Lycosaurus/Vcheck---custom_PCB_and_Arduino-Nano/SCH_Accel Sensing Unit_1-ASU Schematic_2024-08-31.pdf

# YOUT 10 NC 11 XOUT 12 NC 13 VS 14 VS 15 NC 16 EP 17

# ADXL335 Analog G Sensor

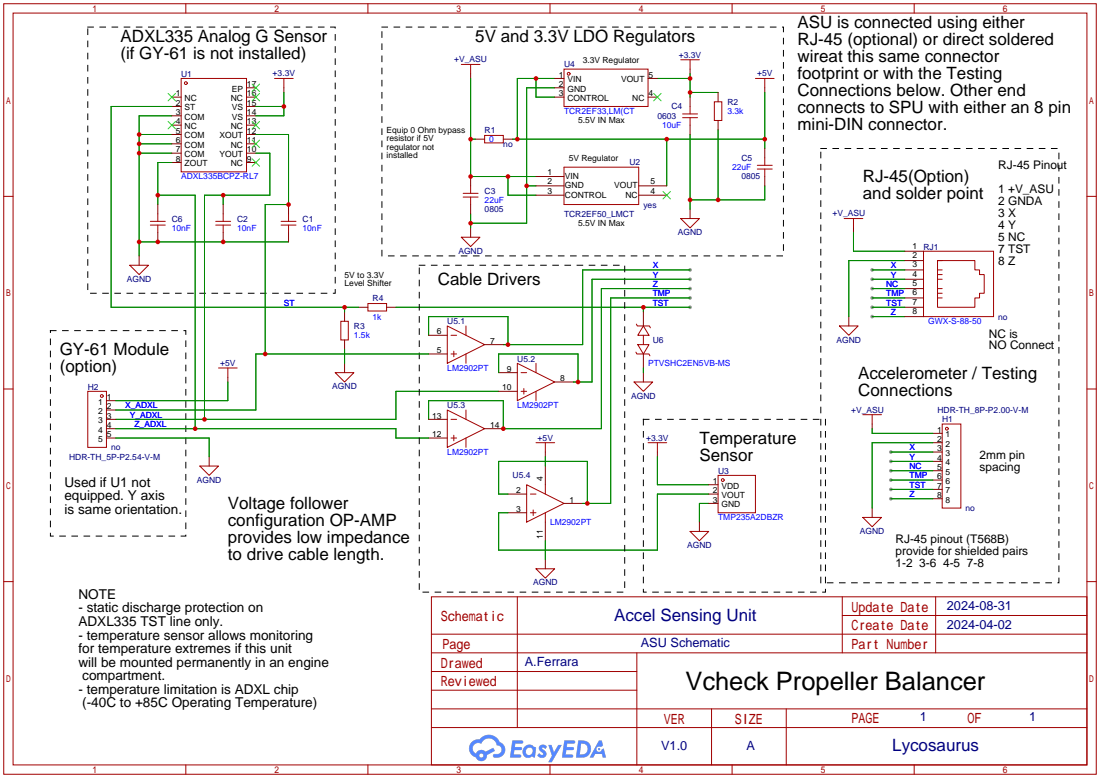
[picture p27: page 1]

ASU is connected using either
RJ-45 (optional) or direct soldered
wireat this same connector
footprint or with the Testing
Connections below. Other end
connects to SPU with either an 8 pin
mini-DIN connector.

(if GY-61 is not installed)

AGND
Voltage follower
configuration OP-AMP
provides low impedance
to drive cable length.

NOTE
- static discharge protection on
ADXL335 TST line only.
- temperature sensor allows monitoring
for temperature extremes if this unit
will be mounted permanently in an engine
compartment.
- temperature limitation is ADXL chip
(-40C to +85C Operating Temperature)
