Lycosaurus/Vcheck---custom_PCB_and_Arduino-Nano/SCH_Signal Processing Unit_1-Power Supply_2024-08-31.pdf

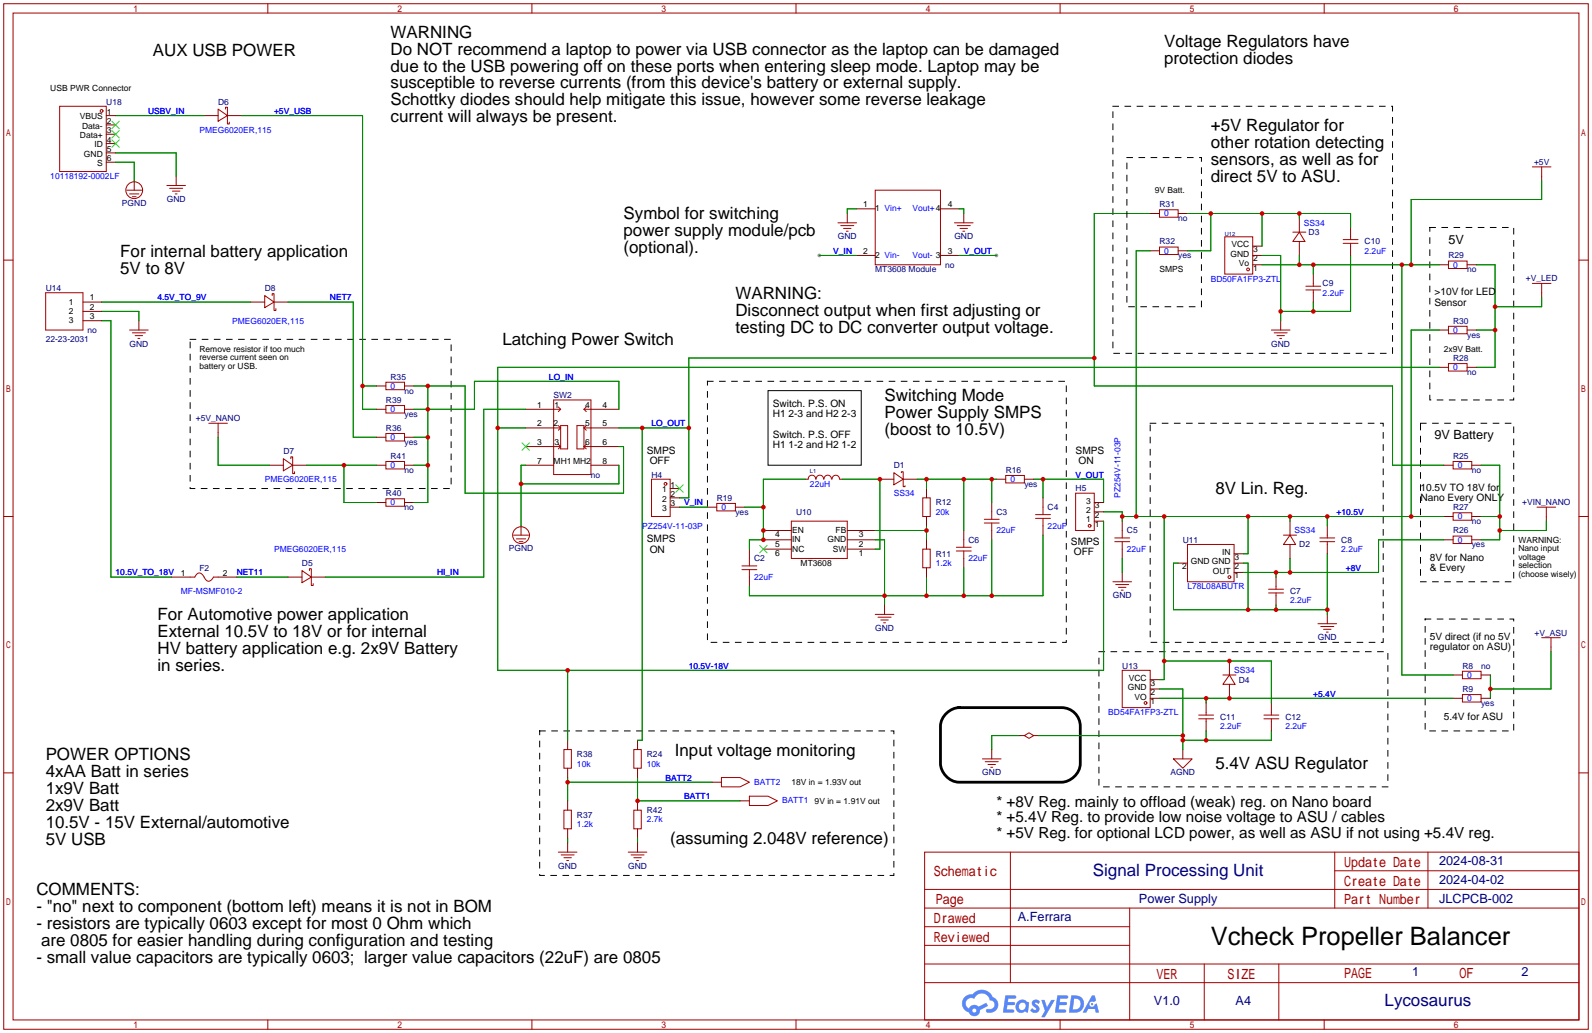
[picture p28: page 1]

WARNING
Do NOT recommend a laptop to power via USB connector as the laptop can be damaged
due to the USB powering off on these ports when entering sleep mode. Laptop may be
susceptible to reverse currents (from this device's battery or external supply.
Schottky diodes should help mitigate this issue, however some reverse leakage
current will always be present.

+5V Regulator for
other rotation detecting
sensors, as well as for
direct 5V to ASU.

PGND
For internal battery application

Symbol for switching
power supply module/pcb
(optional).

WARNING:
Disconnect output when first adjusting or
testing DC to DC converter output voltage.

Remove resistor if too much
reverse current seen on
battery or USB.

MF-MSMF010-2
For Automotive power application
External 10.5V to 18V or for internal
HV battery application e.g. 2x9V Battery
in series.

GND
* +8V Reg. mainly to offload (weak) reg. on Nano board
* +5.4V Reg. to provide low noise voltage to ASU / cables
* +5V Reg. for optional LCD power, as well as ASU if not using +5.4V reg.

COMMENTS:
- "no" next to component (bottom left) means it is not in BOM
- resistors are typically 0603 except for most 0 Ohm which
are 0805 for easier handling during configuration and testing
- small value capacitors are typically 0603; larger value capacitors (22uF) are 0805
