Lycosaurus/Vcheck---custom_PCB_and_Arduino-Nano/SCH_Signal Processing Unit_2-Processing and I-O_2024-08-31.pdf

# Acceleration Sensor and Axis Selector

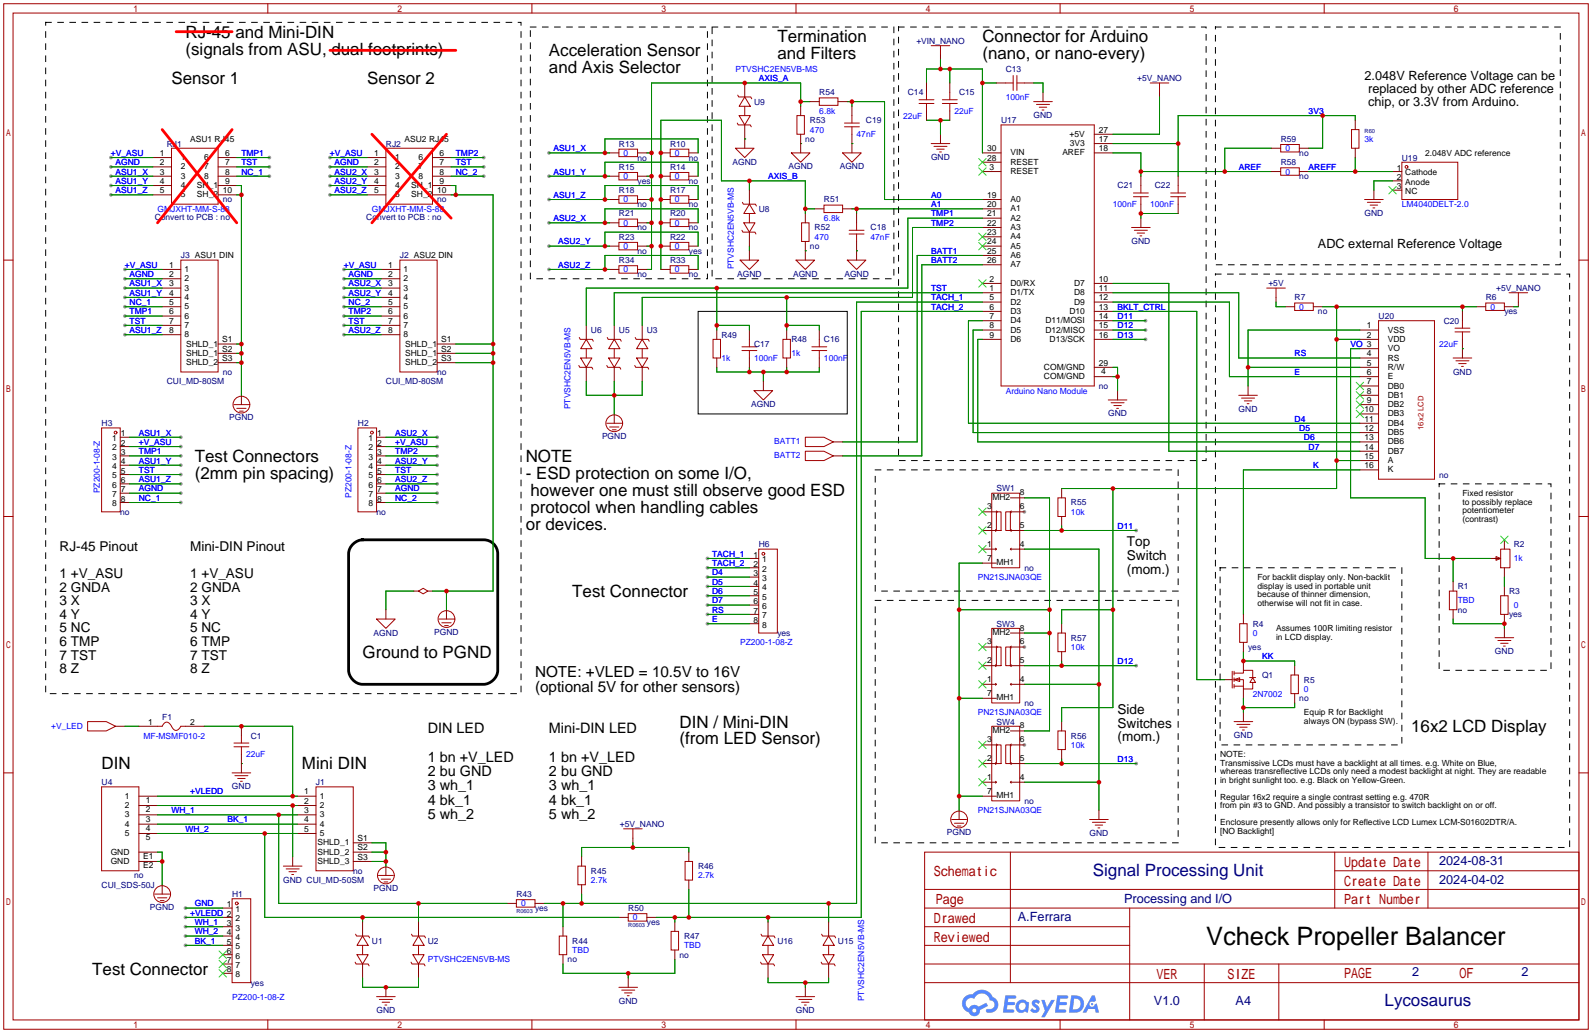
[picture p29: page 1]

RJ-45 and Mini-DIN
(signals from ASU, dual footprints)

Connector for Arduino
(nano, or nano-every)

2.048V Reference Voltage can be
replaced by other ADC reference
chip, or 3.3V from Arduino.

GND
ADC external Reference Voltage

D5 | 12
D6 | 13
D7 | 14
K | 15

NOTE
- ESD protection on some I/O,
however one must still observe good ESD
protocol when handling cables
or devices.

For backlit display only. Non-backlit
display is used in portable unit
because of thinner dimension,
otherwise will not fit in case.

NOTE: +VLED = 10.5V to 16V
(optional 5V for other sensors)

NOTE:
Transmissive LCDs must have a backlight at all times. e.g. White on Blue,
whereas transreflective LCDs only need a modest backlight at night. They are readable
in bright sunlight too. e.g. Black on Yellow-Green.
Regular 16x2 require a single contrast setting e.g. 470R
from pin #3 to GND. And possibly a transistor to switch backlight on or off.
Enclosure presently allows only for Reflective LCD Lumex LCM-S01602DTR/A.
[NO Backlight]
